a-little-wifi/mxm-immobilizer/(threads)

Thread 1 (2024-05-05):

Does it support both Nvidia and AMD cards?

iojeda, 2024-05-05:
Hi
First of all thank you very much for the amazing work you've done and thanks for sharing this great proyect as open source.
I have an old AMD MXM card rescued from a non working iMac from 2009 I was wondering what is the current status of your design and if I could use it safely there.

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

**Have you tested it?**

**Will it support any MXM card?**

In the board desing you say Watch out for propietary MXM pinout stuff might blow up :smile: so I wanted to ask before building it.

**Can you please help me to figure it out if  your design is a good fit for my card?**

**Or maybe just point me in the right direction on where to look for information to figure that out?**

**Will I need specific Driver or manufacturer driver will just work fine?**

Thanks
Regards, Ismael.

a-little-wifi, 2024-05-10:
Hi, sorry to keep you waiting, missed the notification about this.
The current state of the design is 'technically everything is connected, but it could be a lot better'. There's a list of changes I'd still like to make in the readme, but I don't have the time to work on it at the moment.
Regarding what cards it supports, in theory it should support anything that follows the MXM standard reasonably and has its own vbios chip. The proprietary pinout warning applies to cards that completely don't do that.
The card you've pictured, and any MXM card from an Apple device, should be a standard one, no danger of the pinout being different.

Personally, I would not recommend getting this board fabricated just yet, unless you're prepared to deal with whatever might not work as expected. It hasn't been manufactured and tested yet and is pretty much designed specifically to research a lot of the questions you're asking. I want to know the answers myself too, and this project is meant to help me find those answers.

The driver situation might be a funny one. This board itself doesn't need a driver of course, since it's mostly just a passive adapter, but especially with Nvidia MXM cards, the official driver is likely to refuse to install since it doesn't detect a known gpu-laptop combo. There are some ways around that, but that's not something I have tried a lot yet. On the other side of things, AMD doesn't have this kind of limitation as far as I'm aware, pretty sure those drivers should work no problem.

If you want to know more about MXM's weirdness, I would recommend checking out some forum threads about common laptop models that had MXM slots, mostly older HP ZBooks and Dell Precisions, but Apple iMacs too perhaps. There used to be whole communities around those things which included lots of people attempting to upgrade the MXM cards, with lots of useful info about what does and what doesn't work.
Unfortunately some of these older owners lounge threads are no longer easily available since the forum hosting them, forum.notebookreview.com, shut down, but they can still be read on web.archive.org and a dedicated archive website: nbrchive.net. They're lots of fun, would recommend checking them out, that's where I got a lot of my knowledge about MXM.

Hope this helps!

Thread 2 (2024-05-31):

Would like to test it!

Serbak, 2024-05-31:
Hey, I've seen the project and I've been really amazed by it, I would like to help!
I have many mxm cards to burn, so even if the pcb does not work properly and breaks some cards, It's not a big deal to me!

If you can help me print the pcb and make it ready, I'm up for testing!

Here is my discord if you want to talk about this more privately: Serback
:)

a-little-wifi, 2024-05-31:
Ohh hi, glad you like it!
That'd be awesome if you want to help test the design. Getting a fully assembled one will take some work, will need the pcb and parts ordered and assemble it. I'd be happy to help with the details on discord, that'll be a little more convenient. I'll reach out to you there.

Thread 3 (2025-04-01):

MXM Mini GPU

Paffo, 2025-04-01:
Hi,
sorry for creating an issue but i couldn't find your discord here on GH.
I was always interested in making the smallest GPU possible while still being able to more or less DIY it instead of buying it.

My current one is a GTX1060+Oculink and a small Server PSU, the full thing it's as big as a lunchbox, so not very 😅

When i found out that there are resellers for old or refurbished laptop GPUs, in MXM i thought i struck gold, however the MXM to PCIe adapters are prohibitively expensive in places like Aliexpress.

When i found your project i got the idea of slimming it down to be as small as possible, my current idea being Oculink (x4) as for the PCIe and a 200W12V GAN for the power, with just 3 DP ports as output.

Assembling such board would be a piece of cake as i work in electronic repairs, however designing it is another pair of hands, hence my question, do you think this is possible? How much complexity would be added if instead of oculink, straight on an ASM2464 for USB-C?

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

If the incredible (😂😂) Paint mockup didn't give you a stroke, what do you think?

a-little-wifi, 2025-04-01:
Hmm so, one thing to note that I haven't addressed on the PCB in this repo yet, is that MXM cards don't have any of the DC-blocking capacitors on the PCIe lanes which are usually present for half of the pairs on a PCIe card, so they have to be included on the adapter PCB. Other than that I don't think a signal amplifier to redriver or whatever is necessary if the cable run is short enough yeah.
Assuming you don't have much experience routing high-speed differential signals (mostly PCIe and DP in this case), this series on hackaday is an excellent resource (check out the followup articles at the bottom too) https://hackaday.com/2023/03/14/pcie-for-hackers-the-diffpair-prelude/

To slim it down, for most things you don't intend to use you can just straight up remove them and everything related to them yeah, that'll be fine. There's a few parts that are important to the operation of the MXM card in general though, mostly the power and thermal control signals.

For documentation, it's really helped me to look at laptop schematics that include MXM slots for a known working reference implementation (the EliteBook 8540W one is particularly nice for having a directly connected DP port).
You can also find the MXM specification online if you search for something like 'MXM 3.1 specification pdf' (probably slightly less than legal for me to just upload it directly, so you'll have to find it yourself)

Let me know if there's anything else you need, I'm happy to help!

Thread 4 (2025-08-12):

Status of this design

zbrozek, 2025-08-12:
I'd love to get some of these built and have a few questions:

- The readme says that the design isn't done yet; what's missing? How can I help?
- Has one of these been fabricated and tested yet? If so, did it work? If not, what's busted?
- Is this board designed with a cooler in mind? If so, which one?
- Is there a bracket design to go with this so that it can be mounted into a case?

Thanks!
