a-little-wifi/mxm-immobilizer/mxm immobilizer/mxm_immobilizer.kicad_sch

## KiCad design mxm immobilizer/mxm_immobilizer.kicad_sch (2026-01-29)

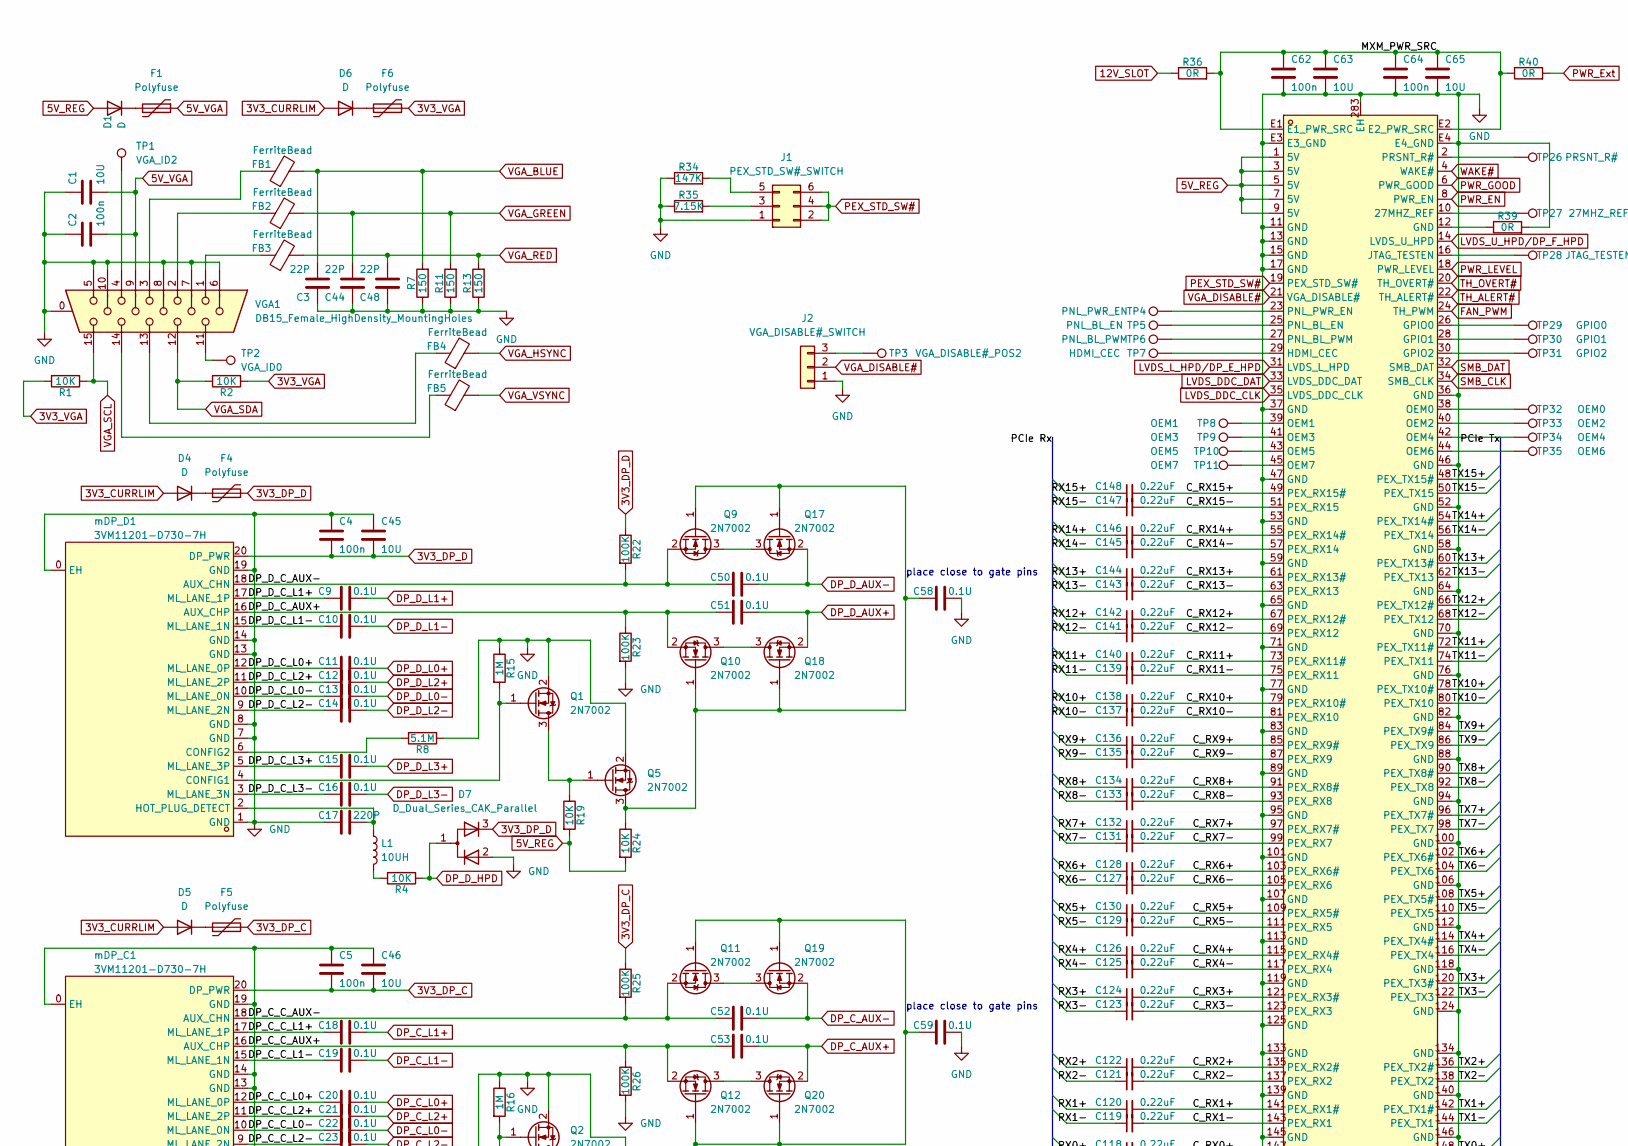
[picture p4: schematic mxm_immobilizer.kicad_sch, part in row 1, column 1]

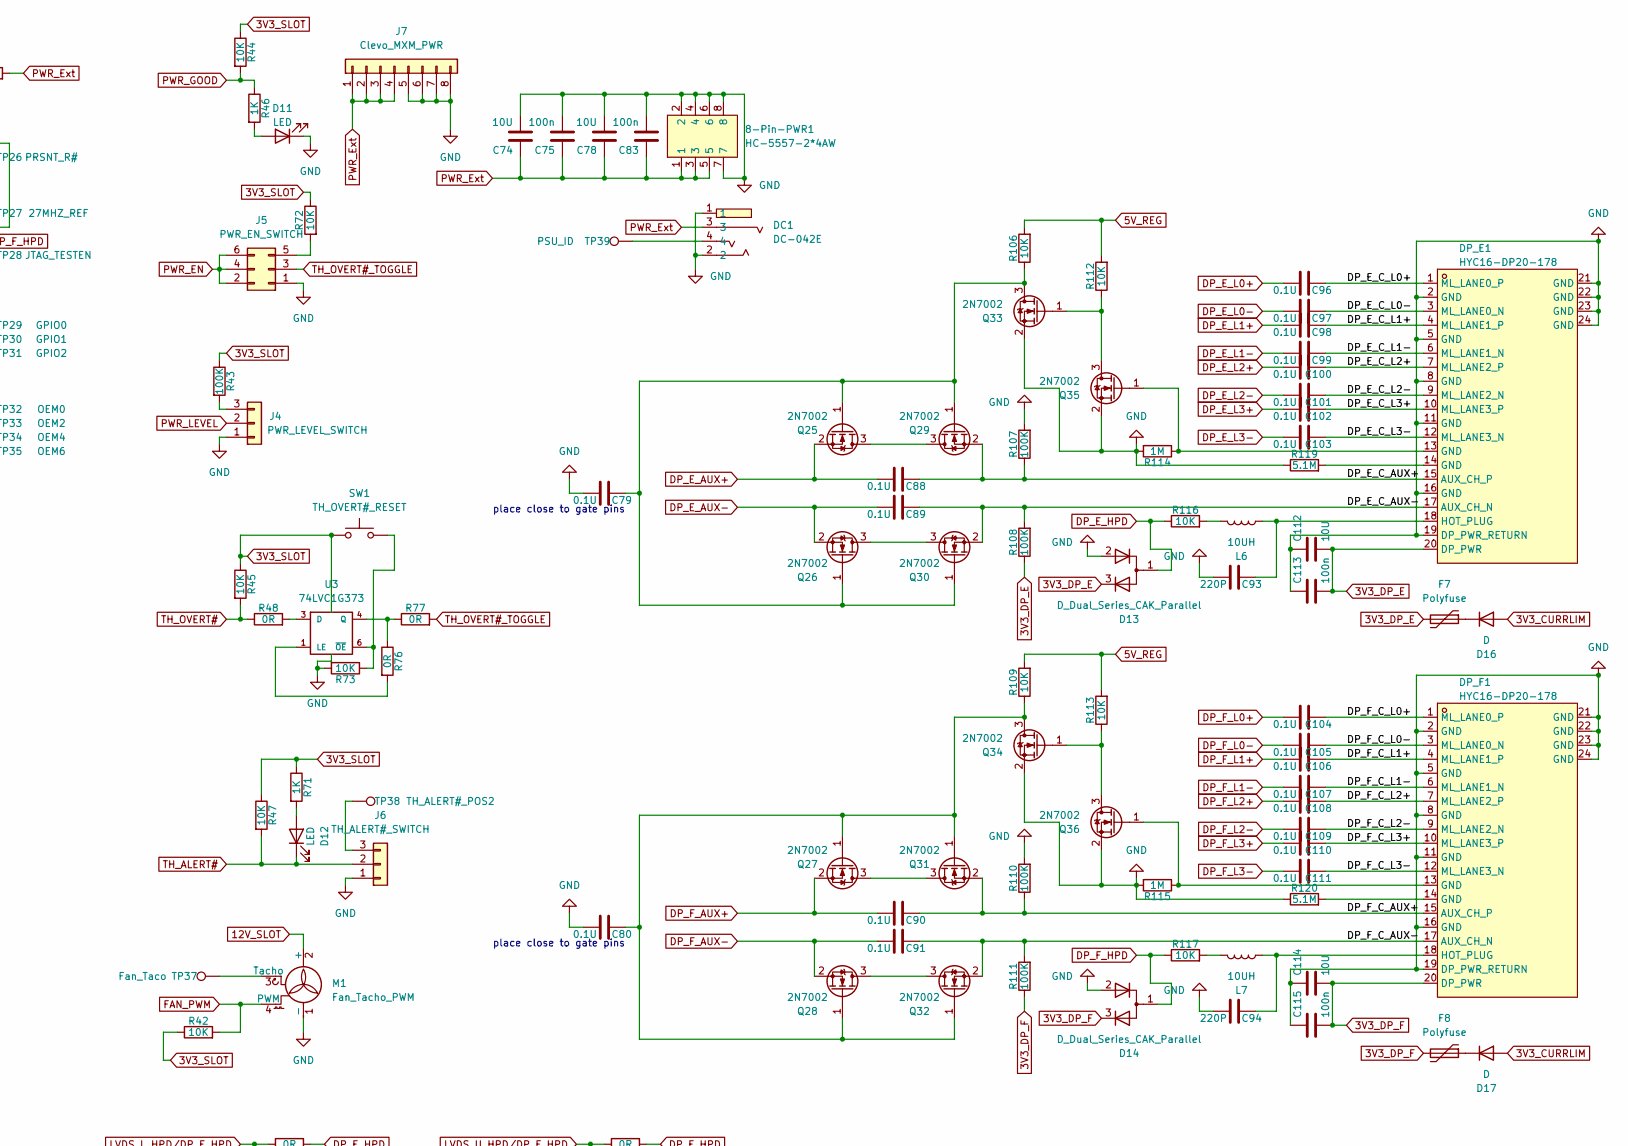
[picture p5: schematic mxm_immobilizer.kicad_sch, part in row 1, column 2]

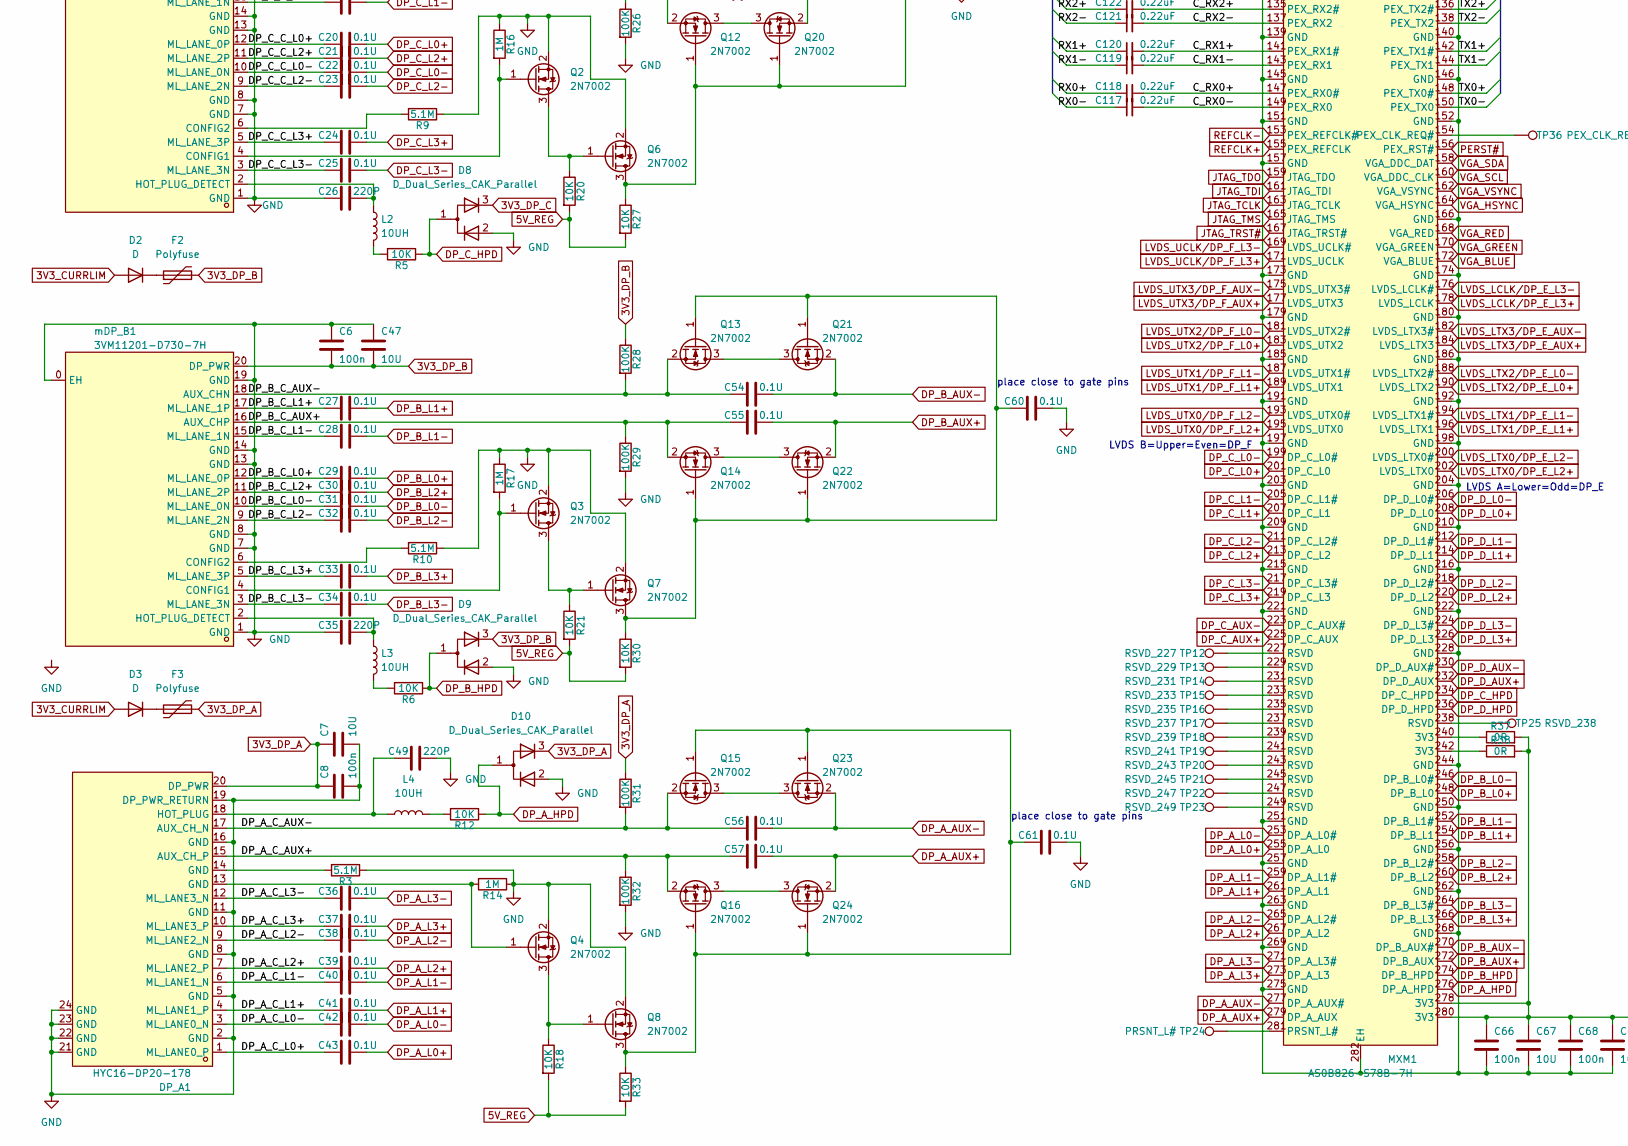
[picture p6: schematic mxm_immobilizer.kicad_sch, part in row 2, column 1]

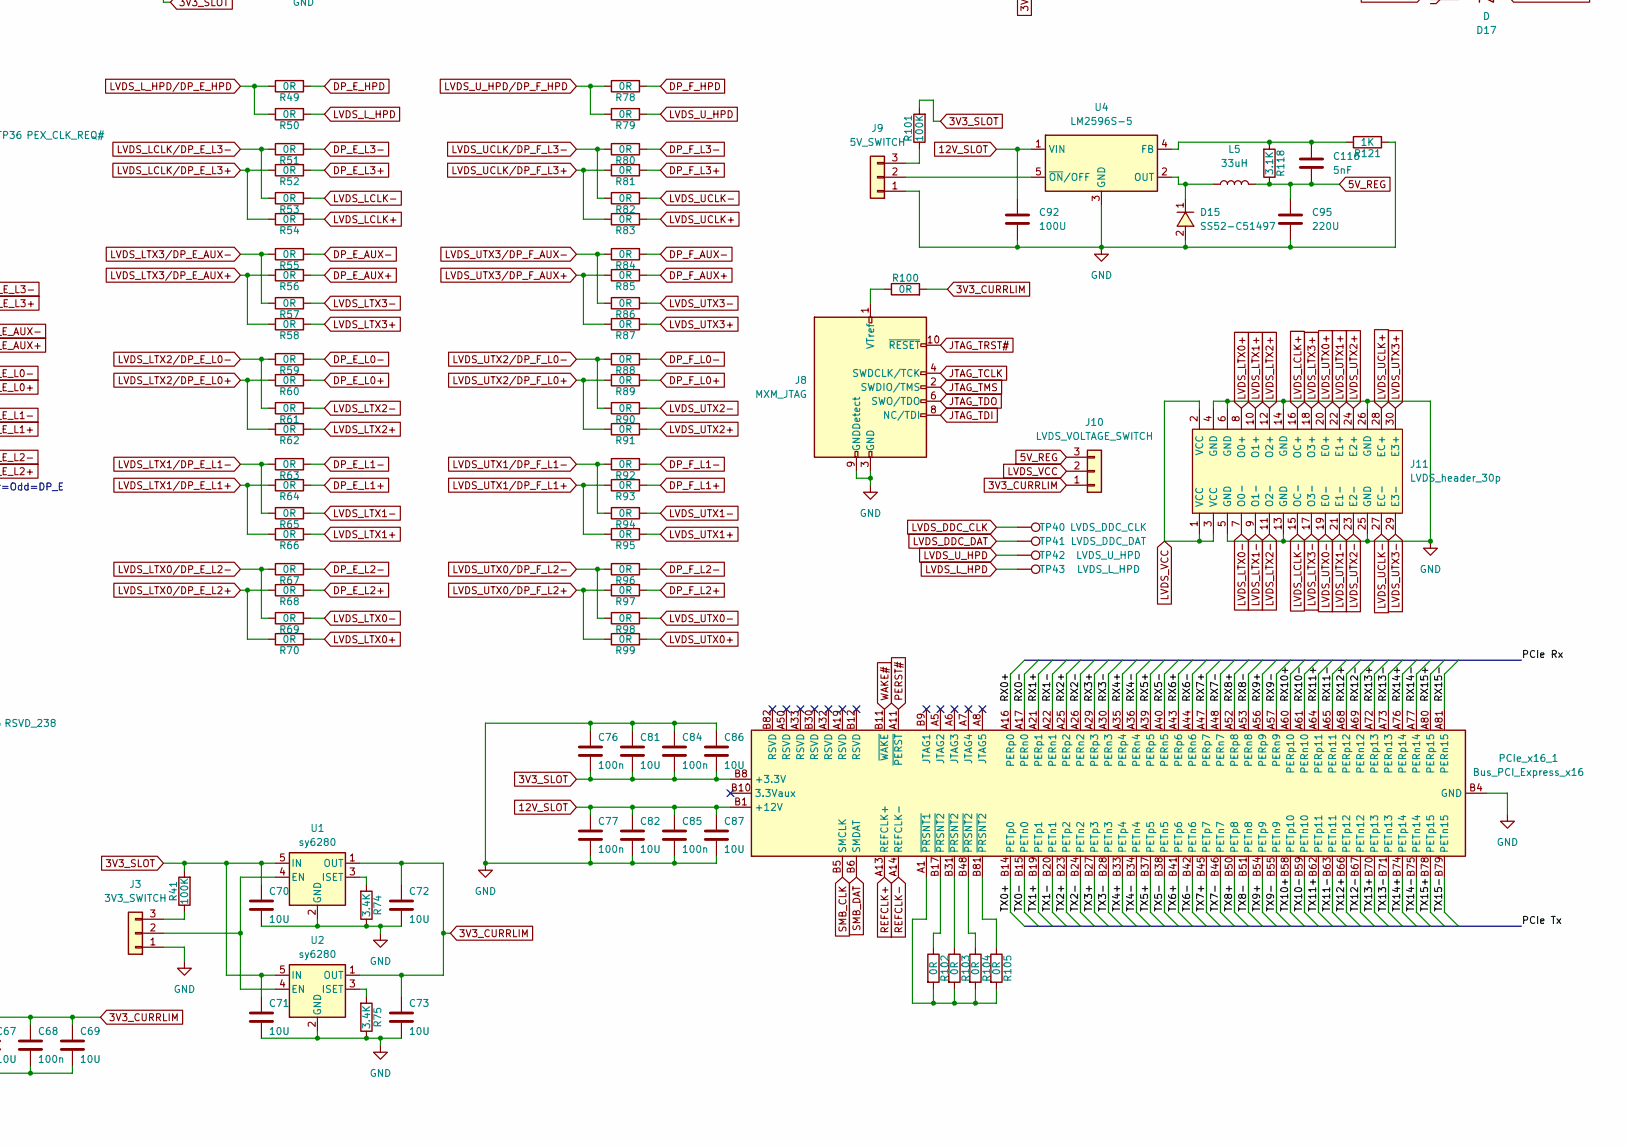
[picture p7: schematic mxm_immobilizer.kicad_sch, part in row 2, column 2]

Parts:
8-Pin-PWR1: HC-5557-2*4AW; CONN-TH_8P-P4.20_5557-2X4AW; LCSC Part C2845789
C1, C7, C45, C46, C47, C63, C65, C67, C69, C70, C71, C72, C73, C74, C78, C81, C82, C86, C87, C112, C114: 10U; C_0603_1608Metric_Pad1.08x0.95mm_HandSolder
C2, C4, C5, C6, C8, C62, C64, C66, C68, C75, C76, C77, C83, C84, C85, C113, C115: 100n; C_0603_1608Metric
C3, C44, C48: 22P; C_0603_1608Metric
C9, C10, C11, C12, C13, C14, C15, C16, C18, C19, C20, C21, C22, C23, C24, C25, C27, C28, C29, C30, C31, C32, C33, C34, C36, C37, C38, C39, C40, C41, C42, C43, C50, C51, C52, C53, C54, C55, C56, C57, C88, C89, C90, C91, C96, C97, C98, C99, C100, C101, C102, C103, C104, C105, C106, C107, C108, C109, C110, C111: 0.1U; C_0402_1005Metric
C17, C26, C35, C49, C93, C94: 220P; C_0603_1608Metric
C58, C59, C60, C61, C79, C80: 0.1U; C_0603_1608Metric
C92: 100U; C_Elec_6.3x7.7
C95: 220U; C_Elec_6.3x7.7
C116: 5nF; C_0603_1608Metric
C117, C118, C119, C120, C121, C122, C123, C124, C125, C126, C127, C128, C129, C130, C131, C132, C133, C134, C135, C136, C137, C138, C139, C140, C141, C142, C143, C144, C145, C146, C147, C148: 0.22uF; C_0402_1005Metric
D1, D2, D3, D4, D5, D6, D16, D17: D; D_SMA
D7, D8, D9, D10, D13, D14: D_Dual_Series_CAK_Parallel; SOT-23
D11, D12: LED; LED_0603_1608Metric
D15: SS52-C51497; SMB_L4.6-W3.6-LS5.3-RD; LCSC Part C51497
DC1: DC-042E; DC-IN-TH_DC-042E; LCSC Part C397340
DP_A1: HYC16-DP20-178; DP-SMD_HYC16-DP20-178; LCSC Part C711350
DP_E1: HYC16-DP20-178; DP-SMD_HYC16-DP20-178; LCSC Part C711350
DP_F1: HYC16-DP20-178; DP-SMD_HYC16-DP20-178; LCSC Part C711350
F1, F2, F3, F4, F5, F6, F7, F8: Polyfuse; Fuse_0805_2012Metric
FB1, FB2, FB3, FB4, FB5: FerriteBead; R_0402_1005Metric
J1: PEX_STD_SW#_SWITCH; PinHeader_2x03_P2.54mm_Vertical
J2: VGA_DISABLE#_SWITCH; PinHeader_1x03_P2.54mm_Vertical
J3: 3V3_SWITCH; PinHeader_1x03_P2.54mm_Vertical
J4: PWR_LEVEL_SWITCH; PinHeader_1x03_P2.54mm_Vertical
J5: PWR_EN_SWITCH; PinHeader_2x03_P2.54mm_Vertical
J6: TH_ALERT#_SWITCH; PinHeader_1x03_P2.54mm_Vertical
J7: Clevo_MXM_PWR; PinHeader_1x08_P2.00mm_Vertical_SMD_Pin1Left
J8: MXM_JTAG; PinHeader_2x05_P1.27mm_Vertical
J9: 5V_SWITCH; PinHeader_1x03_P2.54mm_Vertical
J10: LVDS_VOLTAGE_SWITCH; PinHeader_1x03_P2.54mm_Vertical
J11: LVDS_header_30p; PinHeader_2x15_P2.00mm_Vertical
L1, L2, L3, L4, L6, L7: 10UH; L_0603_1608Metric_Pad1.05x0.95mm_HandSolder
L5: 33uH; L_12x12mm_H8mm
M1: Fan_Tacho_PWM; FanPinHeader_1x04_P2.54mm_Vertical
MXM1: AS0B826-S78B-7H; CONN-SMD_AS0B826-S78B-7H; LCSC Part C426232
PCIe_x16_1: Bus_PCI_Express_x16; BUS_PCIexpress_x16
Q1, Q2, Q3, Q4, Q5, Q6, Q7, Q8, Q9, Q10, Q11, Q12, Q13, Q14, Q15, Q16, Q17, Q18, Q19, Q20, Q21, Q22, Q23, Q24, Q25, Q26, Q27, Q28, Q29, Q30, Q31, Q32, Q33, Q34, Q35, Q36: 2N7002; SOT-23
R1, R2, R4, R5, R6, R12, R18, R19, R20, R21, R24, R27, R30, R33, R42, R44, R45, R47, R72, R73, R106, R109, R112, R113, R116, R117: 10K; R_0603_1608Metric
R3, R8, R9, R10, R119, R120: 5.1M; R_0603_1608Metric
R7, R11, R13: 150; R_0603_1608Metric
R14, R15, R16, R17, R114, R115: 1M; R_0603_1608Metric
R22, R23, R25, R26, R28, R29, R31, R32, R41, R43, R101, R107, R108, R110, R111: 100K; R_0603_1608Metric
R34: 147K; R_0603_1608Metric
R35: 7.15K; R_0603_1608Metric
R36, R40: 0R; R_2816_7142Metric
R37, R38, R39, R48, R49, R50, R51, R52, R53, R54, R55, R56, R57, R58, R59, R60, R61, R62, R63, R64, R65, R66, R67, R68, R69, R70, R76, R77, R78, R79, R80, R81, R82, R83, R84, R85, R86, R87, R88, R89, R90, R91, R92, R93, R94, R95, R96, R97, R98, R99, R100, R102, R103, R104, R105: 0R; R_0603_1608Metric
R46, R71, R121: 1K; R_0603_1608Metric
R74, R75: 3.4K; R_0603_1608Metric
R118: 3.1K; R_0603_1608Metric
SW1: TH_OVERT#_RESET; SW_SPST_EVQPE1
TP1: VGA_ID2; PinHeader_1x01_P2.54mm_Vertical
TP2: VGA_ID0; PinHeader_1x01_P2.54mm_Vertical
TP3: VGA_DISABLE#_POS2; PinHeader_1x01_P2.54mm_Vertical
TP4: PNL_PWR_EN; PinHeader_1x01_P2.54mm_Vertical
TP5: PNL_BL_EN; PinHeader_1x01_P2.54mm_Vertical
TP6: PNL_BL_PWM; PinHeader_1x01_P2.54mm_Vertical
TP7: HDMI_CEC; PinHeader_1x01_P2.54mm_Vertical
TP8: OEM1; PinHeader_1x01_P2.54mm_Vertical
TP9: OEM3; PinHeader_1x01_P2.54mm_Vertical
TP10: OEM5; PinHeader_1x01_P2.54mm_Vertical
TP11: OEM7; PinHeader_1x01_P2.54mm_Vertical
TP12: RSVD_227; PinHeader_1x01_P2.54mm_Vertical
TP13: RSVD_229; PinHeader_1x01_P2.54mm_Vertical
TP14: RSVD_231; PinHeader_1x01_P2.54mm_Vertical
TP15: RSVD_233; PinHeader_1x01_P2.54mm_Vertical
TP16: RSVD_235; PinHeader_1x01_P2.54mm_Vertical
TP17: RSVD_237; PinHeader_1x01_P2.54mm_Vertical
TP18: RSVD_239; PinHeader_1x01_P2.54mm_Vertical
TP19: RSVD_241; PinHeader_1x01_P2.54mm_Vertical
TP20: RSVD_243; PinHeader_1x01_P2.54mm_Vertical
TP21: RSVD_245; PinHeader_1x01_P2.54mm_Vertical
TP22: RSVD_247; PinHeader_1x01_P2.54mm_Vertical
TP23: RSVD_249; PinHeader_1x01_P2.54mm_Vertical
TP24: PRSNT_L#; PinHeader_1x01_P2.54mm_Vertical
TP25: RSVD_238; PinHeader_1x01_P2.54mm_Vertical
TP26: PRSNT_R#; PinHeader_1x01_P2.54mm_Vertical
TP27: 27MHZ_REF; PinHeader_1x01_P2.54mm_Vertical
TP28: JTAG_TESTEN; PinHeader_1x01_P2.54mm_Vertical
TP29: GPIO0; PinHeader_1x01_P2.54mm_Vertical
TP30: GPIO1; PinHeader_1x01_P2.54mm_Vertical
TP31: GPIO2; PinHeader_1x01_P2.54mm_Vertical
TP32: OEM0; PinHeader_1x01_P2.54mm_Vertical
TP33: OEM2; PinHeader_1x01_P2.54mm_Vertical
TP34: OEM4; PinHeader_1x01_P2.54mm_Vertical
TP35: OEM6; PinHeader_1x01_P2.54mm_Vertical
TP36: PEX_CLK_REQ#; PinHeader_1x01_P2.54mm_Vertical
TP37: Fan_Taco; PinHeader_1x01_P2.54mm_Vertical
TP38: TH_ALERT#_POS2; PinHeader_1x01_P2.54mm_Vertical
TP39: PSU_ID; PinHeader_1x01_P2.54mm_Vertical
TP40: LVDS_DDC_CLK; PinHeader_1x01_P2.54mm_Vertical
TP41: LVDS_DDC_DAT; PinHeader_1x01_P2.54mm_Vertical
TP42: LVDS_U_HPD; PinHeader_1x01_P2.54mm_Vertical
TP43: LVDS_L_HPD; PinHeader_1x01_P2.54mm_Vertical
U1, U2: sy6280; SOT-23-5
U3: 74LVC1G373; SOT-23-6
U4: LM2596S-5; TO-263-5_TabPin3
VGA1: DB15_Female_HighDensity_MountingHoles; DSUB-TH_DS1038-15FBNSIA74-0CC
mDP_B1: 3VM11201-D730-7H; CONN-SMD_3VM11201-D730-7H; LCSC Part C2895506
mDP_C1: 3VM11201-D730-7H; CONN-SMD_3VM11201-D730-7H; LCSC Part C2895506
mDP_D1: 3VM11201-D730-7H; CONN-SMD_3VM11201-D730-7H; LCSC Part C2895506

Connections:
3V3_CURRLIM: C66.1, C67.1, C68.1, C69.1, C72.1, C73.1, D2.2 (A), D3.2 (A), D4.2 (A), D5.2 (A), D6.2 (A), D16.2 (A), D17.2 (A), J10.1, MXM1.278 (3V3), MXM1.280 (3V3), R37.2, R38.2, R100.2, U1.1 (OUT), U2.1 (OUT)
3V3_DP_A: C7.1, C8.1, D10.3 (K), DP_A1.20 (DP_PWR), F3.2, R31.1
3V3_DP_B: C6.2, C47.2, D9.3 (K), F2.2, R28.1, mDP_B1.20 (DP_PWR)
3V3_DP_C: C5.2, C46.2, D8.3 (K), F5.2, R25.1, mDP_C1.20 (DP_PWR)
3V3_DP_D: C4.2, C45.2, D7.3 (K), F4.2, R22.1, mDP_D1.20 (DP_PWR)
3V3_DP_E: C112.2, C113.2, D13.3 (K), DP_E1.20 (DP_PWR), F7.2, R108.1
3V3_DP_F: C114.2, C115.2, D14.3 (K), DP_F1.20 (DP_PWR), F8.2, R111.1
3V3_SLOT: C70.1, C71.1, C76.2, C81.2, C84.2, C86.2, PCIe_x16_1.A9 (+3.3V), PCIe_x16_1.A10 (+3.3V), PCIe_x16_1.B8 (+3.3V), R41.2, R42.1, R43.1, R44.1, R45.1, R47.1, R71.1, R72.1, R101.2, SW1.1, U1.5 (IN), U2.5 (IN), U3.5 (VCC)
3V3_VGA: F6.2, R1.2, R2.1
5V_REG: C95.1, C116.2, D1.2 (A), J10.3, L5.2, MXM1.1 (5V), MXM1.3 (5V), MXM1.5 (5V), MXM1.7 (5V), MXM1.9 (5V), R18.2, R19.2, R20.2, R21.2, R24.2, R27.2, R30.2, R33.2, R106.2, R109.2, R112.2, R113.2, R118.1
5V_VGA: C1.2, C2.2, F1.1, VGA1.9 (DDC_5V)
12V_SLOT: C77.1, C82.1, C85.1, C87.1, C92.1, M1.2 (+), PCIe_x16_1.A2 (+12V), PCIe_x16_1.A3 (+12V), PCIe_x16_1.B1 (+12V), PCIe_x16_1.B2 (+12V), PCIe_x16_1.B3 (+12V), R36.1, U4.1 (VIN)
C_RX0+: C118.2, MXM1.147 (PEX_RX0#)
C_RX0-: C117.2, MXM1.149 (PEX_RX0)
C_RX1+: C120.2, MXM1.141 (PEX_RX1#)
C_RX1-: C119.2, MXM1.143 (PEX_RX1)
C_RX2+: C122.2, MXM1.135 (PEX_RX2#)
C_RX2-: C121.2, MXM1.137 (PEX_RX2)
C_RX3+: C124.2, MXM1.121 (PEX_RX3#)
C_RX3-: C123.2, MXM1.123 (PEX_RX3)
C_RX4+: C126.2, MXM1.115 (PEX_RX4#)
C_RX4-: C125.2, MXM1.117 (PEX_RX4)
C_RX5+: C130.2, MXM1.109 (PEX_RX5#)
C_RX5-: C129.2, MXM1.111 (PEX_RX5)
C_RX6+: C128.2, MXM1.103 (PEX_RX6#)
C_RX6-: C127.2, MXM1.105 (PEX_RX6)
C_RX7+: C132.2, MXM1.97 (PEX_RX7#)
C_RX7-: C131.2, MXM1.99 (PEX_RX7)
C_RX8+: C134.2, MXM1.91 (PEX_RX8#)
C_RX8-: C133.2, MXM1.93 (PEX_RX8)
C_RX9+: C136.2, MXM1.85 (PEX_RX9#)
C_RX9-: C135.2, MXM1.87 (PEX_RX9)
C_RX10+: C138.2, MXM1.79 (PEX_RX10#)
C_RX10-: C137.2, MXM1.81 (PEX_RX10)
C_RX11+: C140.2, MXM1.73 (PEX_RX11#)
C_RX11-: C139.2, MXM1.75 (PEX_RX11)
C_RX12+: C142.2, MXM1.67 (PEX_RX12#)
C_RX12-: C141.2, MXM1.69 (PEX_RX12)
C_RX13+: C144.2, MXM1.61 (PEX_RX13#)
C_RX13-: C143.2, MXM1.63 (PEX_RX13)
C_RX14+: C146.2, MXM1.55 (PEX_RX14#)
C_RX14-: C145.2, MXM1.57 (PEX_RX14)
C_RX15+: C148.2, MXM1.49 (PEX_RX15#)
C_RX15-: C147.2, MXM1.51 (PEX_RX15)
DP_A_AUX+: C57.1, MXM1.279 (DP_A_AUX), Q24.2 (S)
DP_A_AUX-: C56.1, MXM1.277 (DP_A_AUX#), Q23.2 (S)
DP_A_C_AUX+: C57.2, DP_A1.15 (AUX_CH_P), Q16.2 (S), R32.1
DP_A_C_AUX-: C56.2, DP_A1.17 (AUX_CH_N), Q15.2 (S), R31.2
DP_A_C_L0+: C43.2, DP_A1.1 (ML_LANE0_P)
DP_A_C_L0-: C42.2, DP_A1.3 (ML_LANE0_N)
DP_A_C_L1+: C41.2, DP_A1.4 (ML_LANE1_P)
DP_A_C_L1-: C40.2, DP_A1.6 (ML_LANE1_N)
DP_A_C_L2+: C39.2, DP_A1.7 (ML_LANE2_P)
DP_A_C_L2-: C38.2, DP_A1.9 (ML_LANE2_N)
DP_A_C_L3+: C37.2, DP_A1.10 (ML_LANE3_P)
DP_A_C_L3-: C36.2, DP_A1.12 (ML_LANE3_N)
DP_A_HPD: D10.1 (A), MXM1.276 (DP_A_HPD), R12.1
DP_A_L0+: C43.1, MXM1.255 (DP_A_L0)
DP_A_L0-: C42.1, MXM1.253 (DP_A_L0#)
DP_A_L1+: C41.1, MXM1.261 (DP_A_L1)
DP_A_L1-: C40.1, MXM1.259 (DP_A_L1#)
DP_A_L2+: C39.1, MXM1.267 (DP_A_L2)
DP_A_L2-: C38.1, MXM1.265 (DP_A_L2#)
DP_A_L3+: C37.1, MXM1.273 (DP_A_L3)
DP_A_L3-: C36.1, MXM1.271 (DP_A_L3#)
DP_B_AUX+: C55.1, MXM1.272 (DP_B_AUX), Q22.2 (S)
DP_B_AUX-: C54.1, MXM1.270 (DP_B_AUX#), Q21.2 (S)
DP_B_C_AUX+: C55.2, Q14.2 (S), R29.1, mDP_B1.16 (AUX_CHP)
DP_B_C_AUX-: C54.2, Q13.2 (S), R28.2, mDP_B1.18 (AUX_CHN)
DP_B_C_L0+: C29.2, mDP_B1.12 (ML_LANE_0P)
DP_B_C_L0-: C31.2, mDP_B1.10 (ML_LANE_0N)
DP_B_C_L1+: C27.2, mDP_B1.17 (ML_LANE_1P)
DP_B_C_L1-: C28.2, mDP_B1.15 (ML_LANE_1N)
DP_B_C_L2+: C30.2, mDP_B1.11 (ML_LANE_2P)
DP_B_C_L2-: C32.2, mDP_B1.9 (ML_LANE_2N)
DP_B_C_L3+: C33.2, mDP_B1.5 (ML_LANE_3P)
DP_B_C_L3-: C34.2, mDP_B1.3 (ML_LANE_3N)
DP_B_HPD: D9.1 (A), MXM1.274 (DP_B_HPD), R6.1
DP_B_L0+: C29.1, MXM1.248 (DP_B_L0)
DP_B_L0-: C31.1, MXM1.246 (DP_B_L0#)
DP_B_L1+: C27.1, MXM1.254 (DP_B_L1)
DP_B_L1-: C28.1, MXM1.252 (DP_B_L1#)
DP_B_L2+: C30.1, MXM1.260 (DP_B_L2)
DP_B_L2-: C32.1, MXM1.258 (DP_B_L2#)
DP_B_L3+: C33.1, MXM1.266 (DP_B_L3)
DP_B_L3-: C34.1, MXM1.264 (DP_B_L3#)
DP_C_AUX+: C53.1, MXM1.225 (DP_C_AUX), Q20.2 (S)
DP_C_AUX-: C52.1, MXM1.223 (DP_C_AUX#), Q19.2 (S)
DP_C_C_AUX+: C53.2, Q12.2 (S), R26.1, mDP_C1.16 (AUX_CHP)
DP_C_C_AUX-: C52.2, Q11.2 (S), R25.2, mDP_C1.18 (AUX_CHN)
DP_C_C_L0+: C20.2, mDP_C1.12 (ML_LANE_0P)
DP_C_C_L0-: C22.2, mDP_C1.10 (ML_LANE_0N)
DP_C_C_L1+: C18.2, mDP_C1.17 (ML_LANE_1P)
DP_C_C_L1-: C19.2, mDP_C1.15 (ML_LANE_1N)
DP_C_C_L2+: C21.2, mDP_C1.11 (ML_LANE_2P)
DP_C_C_L2-: C23.2, mDP_C1.9 (ML_LANE_2N)
DP_C_C_L3+: C24.2, mDP_C1.5 (ML_LANE_3P)
DP_C_C_L3-: C25.2, mDP_C1.3 (ML_LANE_3N)
DP_C_HPD: D8.1 (A), MXM1.234 (DP_C_HPD), R5.1
DP_C_L0+: C20.1, MXM1.201 (DP_C_L0)
DP_C_L0-: C22.1, MXM1.199 (DP_C_L0#)
DP_C_L1+: C18.1, MXM1.207 (DP_C_L1)
DP_C_L1-: C19.1, MXM1.205 (DP_C_L1#)
DP_C_L2+: C21.1, MXM1.213 (DP_C_L2)
DP_C_L2-: C23.1, MXM1.211 (DP_C_L2#)
DP_C_L3+: C24.1, MXM1.219 (DP_C_L3)
DP_C_L3-: C25.1, MXM1.217 (DP_C_L3#)
DP_D_AUX+: C51.1, MXM1.232 (DP_D_AUX), Q18.2 (S)
DP_D_AUX-: C50.1, MXM1.230 (DP_D_AUX#), Q17.2 (S)
DP_D_C_AUX+: C51.2, Q10.2 (S), R23.1, mDP_D1.16 (AUX_CHP)
DP_D_C_AUX-: C50.2, Q9.2 (S), R22.2, mDP_D1.18 (AUX_CHN)
DP_D_C_L0+: C11.2, mDP_D1.12 (ML_LANE_0P)
DP_D_C_L0-: C13.2, mDP_D1.10 (ML_LANE_0N)
DP_D_C_L1+: C9.2, mDP_D1.17 (ML_LANE_1P)
DP_D_C_L1-: C10.2, mDP_D1.15 (ML_LANE_1N)
DP_D_C_L2+: C12.2, mDP_D1.11 (ML_LANE_2P)
DP_D_C_L2-: C14.2, mDP_D1.9 (ML_LANE_2N)
DP_D_C_L3+: C15.2, mDP_D1.5 (ML_LANE_3P)
DP_D_C_L3-: C16.2, mDP_D1.3 (ML_LANE_3N)
DP_D_HPD: D7.1 (A), MXM1.236 (DP_D_HPD), R4.1
DP_D_L0+: C11.1, MXM1.208 (DP_D_L0)
DP_D_L0-: C13.1, MXM1.206 (DP_D_L0#)
DP_D_L1+: C9.1, MXM1.214 (DP_D_L1)
DP_D_L1-: C10.1, MXM1.212 (DP_D_L1#)
DP_D_L2+: C12.1, MXM1.220 (DP_D_L2)
DP_D_L2-: C14.1, MXM1.218 (DP_D_L2#)
DP_D_L3+: C15.1, MXM1.226 (DP_D_L3)
DP_D_L3-: C16.1, MXM1.224 (DP_D_L3#)
DP_E_AUX+: C88.1, Q25.2 (S), R56.2
DP_E_AUX-: C89.1, Q26.2 (S), R55.2
DP_E_C_AUX+: C88.2, DP_E1.15 (AUX_CH_P), Q29.2 (S), R107.1
DP_E_C_AUX-: C89.2, DP_E1.17 (AUX_CH_N), Q30.2 (S), R108.2
DP_E_C_L0+: C96.2, DP_E1.1 (ML_LANE0_P)
DP_E_C_L0-: C97.2, DP_E1.3 (ML_LANE0_N)
DP_E_C_L1+: C98.2, DP_E1.4 (ML_LANE1_P)
DP_E_C_L1-: C99.2, DP_E1.6 (ML_LANE1_N)
DP_E_C_L2+: C100.2, DP_E1.7 (ML_LANE2_P)
DP_E_C_L2-: C101.2, DP_E1.9 (ML_LANE2_N)
DP_E_C_L3+: C102.2, DP_E1.10 (ML_LANE3_P)
DP_E_C_L3-: C103.2, DP_E1.12 (ML_LANE3_N)
DP_E_HPD: D13.1 (A), R49.2, R116.1
DP_E_L0+: C96.1, R60.2
DP_E_L0-: C97.1, R59.2
DP_E_L1+: C98.1, R64.2
DP_E_L1-: C99.1, R63.2
DP_E_L2+: C100.1, R68.2
DP_E_L2-: C101.1, R67.2
DP_E_L3+: C102.1, R52.2
DP_E_L3-: C103.1, R51.2
DP_F_AUX+: C90.1, Q27.2 (S), R85.2
DP_F_AUX-: C91.1, Q28.2 (S), R84.2
DP_F_C_AUX+: C90.2, DP_F1.15 (AUX_CH_P), Q31.2 (S), R110.1
DP_F_C_AUX-: C91.2, DP_F1.17 (AUX_CH_N), Q32.2 (S), R111.2
DP_F_C_L0+: C104.2, DP_F1.1 (ML_LANE0_P)
DP_F_C_L0-: C105.2, DP_F1.3 (ML_LANE0_N)
DP_F_C_L1+: C106.2, DP_F1.4 (ML_LANE1_P)
DP_F_C_L1-: C107.2, DP_F1.6 (ML_LANE1_N)
DP_F_C_L2+: C108.2, DP_F1.7 (ML_LANE2_P)
DP_F_C_L2-: C109.2, DP_F1.9 (ML_LANE2_N)
DP_F_C_L3+: C110.2, DP_F1.10 (ML_LANE3_P)
DP_F_C_L3-: C111.2, DP_F1.12 (ML_LANE3_N)
DP_F_HPD: D14.1 (A), R78.2, R117.1
DP_F_L0+: C104.1, R89.2
DP_F_L0-: C105.1, R88.2
DP_F_L1+: C106.1, R93.2
DP_F_L1-: C107.1, R92.2
DP_F_L2+: C108.1, R97.2
DP_F_L2-: C109.1, R96.2
DP_F_L3+: C110.1, R81.2
DP_F_L3-: C111.1, R80.2
FAN_PWM: M1.4 (PWM), MXM1.24 (TH_PWM), R42.2
GND: 8-Pin-PWR1.2, 8-Pin-PWR1.4, 8-Pin-PWR1.6, 8-Pin-PWR1.7, 8-Pin-PWR1.8, C1.1, C2.1, C3.1, C4.1, C5.1, C6.1, C7.2, C8.2, C17.2, C26.2, C35.2, C44.1, C45.1, C46.1, C47.1, C48.1, C49.1, C58.1, C59.1, C60.1, C61.1, C62.2, C63.2, C64.2, C65.2, C66.2, C67.2, C68.2, C69.2, C70.2, C71.2, C72.2, C73.2, C74.2, C75.2, C76.1, C77.2, C78.2, C79.1, C80.1, C81.1, C82.2, C83.2, C84.1, C85.2, C86.1, C87.2, C92.2, C93.1, C94.1, C95.2, C112.1, C113.1, C114.1, C115.1, D7.2 (K), D8.2 (K), D9.2 (K), D10.2 (K), D11.1 (K), D13.2 (K), D14.2 (K), D15.2 (A), DC1.1, DC1.2, DP_A1.2 (GND), DP_A1.5 (GND), DP_A1.8 (GND), DP_A1.11 (GND), DP_A1.16 (GND), DP_A1.19 (DP_PWR_RETURN), DP_A1.21 (GND), DP_A1.22 (GND), DP_A1.23 (GND), DP_A1.24 (GND), DP_E1.2 (GND), DP_E1.5 (GND), DP_E1.8 (GND), DP_E1.11 (GND), DP_E1.16 (GND), DP_E1.19 (DP_PWR_RETURN), DP_E1.21 (GND), DP_E1.22 (GND), DP_E1.23 (GND), DP_E1.24 (GND), DP_F1.2 (GND), DP_F1.5 (GND), DP_F1.8 (GND), DP_F1.11 (GND), DP_F1.16 (GND), DP_F1.19 (DP_PWR_RETURN), DP_F1.21 (GND), DP_F1.22 (GND), DP_F1.23 (GND), DP_F1.24 (GND), J1.1, J2.1, J3.1, J4.1, J5.1, J6.1, J7.5, J7.6, J7.7, J7.8, J8.3 (GND), J8.5 (GND), J8.9 (GNDDetect), J9.1, J11.4 (GND), J11.5 (GND), J11.6 (GND), J11.13 (GND), J11.14 (GND), J11.25 (GND), J11.26 (GND), M1.1 (-), MXM1.11 (GND), MXM1.13 (GND), MXM1.15 (GND), MXM1.17 (GND), MXM1.36 (GND), MXM1.37 (GND), MXM1.46 (GND), MXM1.47 (GND), MXM1.52 (GND), MXM1.53 (GND), MXM1.58 (GND), MXM1.59 (GND), MXM1.64 (GND), MXM1.65 (GND), MXM1.70 (GND), MXM1.71 (GND), MXM1.76 (GND), MXM1.77 (GND), MXM1.82 (GND), MXM1.83 (GND), MXM1.88 (GND), MXM1.89 (GND), MXM1.94 (GND), MXM1.95 (GND), MXM1.100 (GND), MXM1.101 (GND), MXM1.106 (GND), MXM1.107 (GND), MXM1.112 (GND), MXM1.113 (GND), MXM1.118 (GND), MXM1.119 (GND), MXM1.124 (GND), MXM1.125 (GND), MXM1.133 (GND), MXM1.134 (GND), MXM1.139 (GND), MXM1.140 (GND), MXM1.145 (GND), MXM1.146 (GND), MXM1.151 (GND), MXM1.152 (GND), MXM1.157 (GND), MXM1.166 (GND), MXM1.173 (GND), MXM1.174 (GND), MXM1.179 (GND), MXM1.180 (GND), MXM1.185 (GND), MXM1.186 (GND), MXM1.191 (GND), MXM1.192 (GND), MXM1.197 (GND), MXM1.198 (GND), MXM1.203 (GND), MXM1.204 (GND), MXM1.209 (GND), MXM1.210 (GND), MXM1.215 (GND), MXM1.216 (GND), MXM1.221 (GND), MXM1.222 (GND), MXM1.228 (GND), MXM1.244 (GND), MXM1.250 (GND), MXM1.251 (GND), MXM1.256 (GND), MXM1.257 (GND), MXM1.262 (GND), MXM1.263 (GND), MXM1.268 (GND), MXM1.269 (GND), MXM1.275 (GND), MXM1.282 (EH), MXM1.283 (EH), MXM1.E3 (E3_GND), MXM1.E4 (E4_GND), PCIe_x16_1.A4 (GND), PCIe_x16_1.A12 (GND), PCIe_x16_1.A15 (GND), PCIe_x16_1.A18 (GND), PCIe_x16_1.A20 (GND), PCIe_x16_1.A23 (GND), PCIe_x16_1.A24 (GND), PCIe_x16_1.A27 (GND), PCIe_x16_1.A28 (GND), PCIe_x16_1.A31 (GND), PCIe_x16_1.A34 (GND), PCIe_x16_1.A37 (GND), PCIe_x16_1.A38 (GND), PCIe_x16_1.A41 (GND), PCIe_x16_1.A42 (GND), PCIe_x16_1.A45 (GND), PCIe_x16_1.A46 (GND), PCIe_x16_1.A49 (GND), PCIe_x16_1.A51 (GND), PCIe_x16_1.A54 (GND), PCIe_x16_1.A55 (GND), PCIe_x16_1.A58 (GND), PCIe_x16_1.A59 (GND), PCIe_x16_1.A62 (GND), PCIe_x16_1.A63 (GND), PCIe_x16_1.A66 (GND), PCIe_x16_1.A67 (GND), PCIe_x16_1.A70 (GND), PCIe_x16_1.A71 (GND), PCIe_x16_1.A74 (GND), PCIe_x16_1.A75 (GND), PCIe_x16_1.A78 (GND), PCIe_x16_1.A79 (GND), PCIe_x16_1.A82 (GND), PCIe_x16_1.B4 (GND), PCIe_x16_1.B7 (GND), PCIe_x16_1.B13 (GND), PCIe_x16_1.B16 (GND), PCIe_x16_1.B18 (GND), PCIe_x16_1.B21 (GND), PCIe_x16_1.B22 (GND), PCIe_x16_1.B25 (GND), PCIe_x16_1.B26 (GND), PCIe_x16_1.B29 (GND), PCIe_x16_1.B32 (GND), PCIe_x16_1.B35 (GND), PCIe_x16_1.B36 (GND), PCIe_x16_1.B39 (GND), PCIe_x16_1.B40 (GND), PCIe_x16_1.B43 (GND), PCIe_x16_1.B44 (GND), PCIe_x16_1.B47 (GND), PCIe_x16_1.B49 (GND), PCIe_x16_1.B52 (GND), PCIe_x16_1.B53 (GND), PCIe_x16_1.B56 (GND), PCIe_x16_1.B57 (GND), PCIe_x16_1.B60 (GND), PCIe_x16_1.B61 (GND), PCIe_x16_1.B64 (GND), PCIe_x16_1.B65 (GND), PCIe_x16_1.B68 (GND), PCIe_x16_1.B69 (GND), PCIe_x16_1.B72 (GND), PCIe_x16_1.B73 (GND), PCIe_x16_1.B76 (GND), PCIe_x16_1.B77 (GND), PCIe_x16_1.B80 (GND), Q1.2 (S), Q2.2 (S), Q3.2 (S), Q4.2 (S), Q5.2 (S), Q6.2 (S), Q7.2 (S), Q8.2 (S), Q33.2 (S), Q34.2 (S), Q35.2 (S), Q36.2 (S), R3.1, R7.1, R8.1, R9.1, R10.1, R11.1, R13.1, R14.1, R15.1, R16.1, R17.1, R23.2, R26.2, R29.2, R32.2, R34.1, R35.1, R39.2, R73.2, R74.1, R75.1, R107.2, R110.2, R114.2, R115.2, R119.1, R120.1, R121.2, U1.2 (GND), U2.2 (GND), U3.2 (GND), U4.3 (GND), VGA1.0, VGA1.5 (GND), VGA1.6 (RED_SHIELD), VGA1.7 (GREEN_SHIELD), VGA1.8 (BLUE_SHIELD), VGA1.10 (SYNC_RETURN), mDP_B1.0 (EH), mDP_B1.1 (GND), mDP_B1.7 (GND), mDP_B1.8 (GND), mDP_B1.13 (GND), mDP_B1.14 (GND), mDP_B1.19 (GND), mDP_C1.0 (EH), mDP_C1.1 (GND), mDP_C1.7 (GND), mDP_C1.8 (GND), mDP_C1.13 (GND), mDP_C1.14 (GND), mDP_C1.19 (GND), mDP_D1.0 (EH), mDP_D1.1 (GND), mDP_D1.7 (GND), mDP_D1.8 (GND), mDP_D1.13 (GND), mDP_D1.14 (GND), mDP_D1.19 (GND)
JTAG_TCLK: J8.4 (SWDCLK/TCK), MXM1.163 (JTAG_TCLK)
JTAG_TDI: J8.8 (NC/TDI), MXM1.161 (JTAG_TDI)
JTAG_TDO: J8.6 (SWO/TDO), MXM1.159 (JTAG_TDO)
JTAG_TMS: J8.2 (SWDIO/TMS), MXM1.165 (JTAG_TMS)
JTAG_TRST#: J8.10 (~RESET), MXM1.167 (JTAG_TRST#)
LVDS_DDC_CLK: MXM1.35 (LVDS_DDC_CLK), TP40.1
LVDS_DDC_DAT: MXM1.33 (LVDS_DDC_DAT), TP41.1
LVDS_LCLK+: J11.16 (OC+), R54.2
LVDS_LCLK-: J11.15 (OC-), R53.2
LVDS_LCLK/DP_E_L3+: MXM1.178 (LVDS_LCLK), R52.1, R54.1
LVDS_LCLK/DP_E_L3-: MXM1.176 (LVDS_LCLK#), R51.1, R53.1
LVDS_LTX0+: J11.8 (O0+), R70.2
LVDS_LTX0-: J11.7 (O0-), R69.2
LVDS_LTX0/DP_E_L2+: MXM1.202 (LVDS_LTX0), R68.1, R70.1
LVDS_LTX0/DP_E_L2-: MXM1.200 (LVDS_LTX0#), R67.1, R69.1
LVDS_LTX1+: J11.10 (O1+), R66.2
LVDS_LTX1-: J11.9 (O1-), R65.2
LVDS_LTX1/DP_E_L1+: MXM1.196 (LVDS_LTX1), R64.1, R66.1
LVDS_LTX1/DP_E_L1-: MXM1.194 (LVDS_LTX1#), R63.1, R65.1
LVDS_LTX2+: J11.12 (O2+), R62.2
LVDS_LTX2-: J11.11 (O2-), R61.2
LVDS_LTX2/DP_E_L0+: MXM1.190 (LVDS_LTX2), R60.1, R62.1
LVDS_LTX2/DP_E_L0-: MXM1.188 (LVDS_LTX2#), R59.1, R61.1
LVDS_LTX3+: J11.18 (O3+), R58.2
LVDS_LTX3-: J11.17 (O3-), R57.2
LVDS_LTX3/DP_E_AUX+: MXM1.184 (LVDS_LTX3), R56.1, R58.1
LVDS_LTX3/DP_E_AUX-: MXM1.182 (LVDS_LTX3#), R55.1, R57.1
LVDS_L_HPD: R50.2, TP43.1
LVDS_L_HPD/DP_E_HPD: MXM1.31 (LVDS_L_HPD), R49.1, R50.1
LVDS_UCLK+: J11.28 (EC+), R83.2
LVDS_UCLK-: J11.27 (EC-), R82.2
LVDS_UCLK/DP_F_L3+: MXM1.171 (LVDS_UCLK), R81.1, R83.1
LVDS_UCLK/DP_F_L3-: MXM1.169 (LVDS_UCLK#), R80.1, R82.1
LVDS_UTX0+: J11.20 (E0+), R99.2
LVDS_UTX0-: J11.19 (E0-), R98.2
LVDS_UTX0/DP_F_L2+: MXM1.195 (LVDS_UTX0), R97.1, R99.1
LVDS_UTX0/DP_F_L2-: MXM1.193 (LVDS_UTX0#), R96.1, R98.1
LVDS_UTX1+: J11.22 (E1+), R95.2
LVDS_UTX1-: J11.21 (E1-), R94.2
LVDS_UTX1/DP_F_L1+: MXM1.189 (LVDS_UTX1), R93.1, R95.1
LVDS_UTX1/DP_F_L1-: MXM1.187 (LVDS_UTX1#), R92.1, R94.1
LVDS_UTX2+: J11.24 (E2+), R91.2
LVDS_UTX2-: J11.23 (E2-), R90.2
LVDS_UTX2/DP_F_L0+: MXM1.183 (LVDS_UTX2), R89.1, R91.1
LVDS_UTX2/DP_F_L0-: MXM1.181 (LVDS_UTX2#), R88.1, R90.1
LVDS_UTX3+: J11.30 (E3+), R87.2
LVDS_UTX3-: J11.29 (E3-), R86.2
LVDS_UTX3/DP_F_AUX+: MXM1.177 (LVDS_UTX3), R85.1, R87.1
LVDS_UTX3/DP_F_AUX-: MXM1.175 (LVDS_UTX3#), R84.1, R86.1
LVDS_U_HPD: R79.2, TP42.1
LVDS_U_HPD/DP_F_HPD: MXM1.14 (LVDS_U_HPD), R78.1, R79.1
LVDS_VCC: J10.2, J11.1 (VCC), J11.2 (VCC), J11.3 (VCC)
MXM_PWR_SRC: C62.1, C63.1, C64.1, C65.1, MXM1.E1 (E1_PWR_SRC), MXM1.E2 (E2_PWR_SRC), R36.2, R40.1
unnamed: C17.1, L1.1, mDP_D1.2 (HOT_PLUG_DETECT)
unnamed: C26.1, L2.1, mDP_C1.2 (HOT_PLUG_DETECT)
unnamed: C35.1, L3.1, mDP_B1.2 (HOT_PLUG_DETECT)
unnamed: C49.2, DP_A1.18 (HOT_PLUG), L4.1
unnamed: C58.2, Q5.3 (D), Q9.1 (G), Q10.1 (G), Q17.1 (G), Q18.1 (G), R24.1
unnamed: C59.2, Q6.3 (D), Q11.1 (G), Q12.1 (G), Q19.1 (G), Q20.1 (G), R27.1
unnamed: C60.2, Q7.3 (D), Q13.1 (G), Q14.1 (G), Q21.1 (G), Q22.1 (G), R30.1
unnamed: C61.2, Q8.3 (D), Q15.1 (G), Q16.1 (G), Q23.1 (G), Q24.1 (G), R33.1
unnamed: C79.2, Q25.1 (G), Q26.1 (G), Q29.1 (G), Q30.1 (G), Q33.3 (D), R106.1
unnamed: C80.2, Q27.1 (G), Q28.1 (G), Q31.1 (G), Q32.1 (G), Q34.3 (D), R109.1
unnamed: C93.2, DP_E1.18 (HOT_PLUG), L6.1
unnamed: C94.2, DP_F1.18 (HOT_PLUG), L7.1
unnamed: C116.1, R118.2, R121.1, U4.4 (FB)
unnamed: D1.1 (K), F1.2
unnamed: D2.1 (K), F2.1
unnamed: D3.1 (K), F3.1
unnamed: D4.1 (K), F4.1
unnamed: D5.1 (K), F5.1
unnamed: D6.1 (K), F6.1
unnamed: D11.2 (A), R46.2
unnamed: D12.2 (A), R71.2
unnamed: D15.1 (C), L5.1, U4.2 (OUT)
unnamed: D16.1 (K), F7.1
unnamed: D17.1 (K), F8.1
unnamed: DC1.4, TP39.1
unnamed: DP_A1.13 (GND), Q4.1 (G), R14.2
unnamed: DP_A1.14 (GND), R3.2
unnamed: DP_E1.13 (GND), Q35.1 (G), R114.1
unnamed: DP_E1.14 (GND), R119.2
unnamed: DP_F1.13 (GND), Q36.1 (G), R115.1
unnamed: DP_F1.14 (GND), R120.2
unnamed: FB1.1, VGA1.3 (BLUE)
unnamed: FB2.1, VGA1.2 (GREEN)
unnamed: FB3.1, VGA1.1 (RED)
unnamed: FB4.1, VGA1.13 (HSYNC)
unnamed: FB5.1, VGA1.14 (VSYNC)
unnamed: J1.3, R35.2
unnamed: J1.5, R34.2
unnamed: J2.3, TP3.1
unnamed: J3.2, U1.4 (EN), U2.4 (EN)
unnamed: J3.3, R41.1
unnamed: J4.3, R43.2
unnamed: J5.5, R72.2
unnamed: J6.3, TP38.1
unnamed: J8.1 (VTref), R100.1
unnamed: J9.2, U4.5 (~ON/OFF)
unnamed: J9.3, R101.1
unnamed: L1.2, R4.2
unnamed: L2.2, R5.2
unnamed: L3.2, R6.2
unnamed: L4.2, R12.2
unnamed: L6.2, R116.2
unnamed: L7.2, R117.2
unnamed: M1.3 (Tacho), TP37.1
unnamed: MXM1.2 (PRSNT_R#), TP26.1
unnamed: MXM1.10 (27MHZ_REF), TP27.1
unnamed: MXM1.12 (GND), R39.1
unnamed: MXM1.16 (JTAG_TESTEN), TP28.1
unnamed: MXM1.23 (PNL_PWR_EN), TP4.1
unnamed: MXM1.25 (PNL_BL_EN), TP5.1
unnamed: MXM1.26 (GPIO0), TP29.1
unnamed: MXM1.27 (PNL_BL_PWM), TP6.1
unnamed: MXM1.28 (GPIO1), TP30.1
unnamed: MXM1.29 (HDMI_CEC), TP7.1
unnamed: MXM1.30 (GPIO2), TP31.1
unnamed: MXM1.38 (OEM0), TP32.1
unnamed: MXM1.39 (OEM1), TP8.1
unnamed: MXM1.40 (OEM2), TP33.1
unnamed: MXM1.41 (OEM3), TP9.1
unnamed: MXM1.42 (OEM4), TP34.1
unnamed: MXM1.43 (OEM5), TP10.1
unnamed: MXM1.44 (OEM6), TP35.1
unnamed: MXM1.45 (OEM7), TP11.1
unnamed: MXM1.154 (PEX_CLK_REQ#), TP36.1
unnamed: MXM1.227 (RSVD), TP12.1
unnamed: MXM1.229 (RSVD), TP13.1
unnamed: MXM1.231 (RSVD), TP14.1
unnamed: MXM1.233 (RSVD), TP15.1
unnamed: MXM1.235 (RSVD), TP16.1
unnamed: MXM1.237 (RSVD), TP17.1
unnamed: MXM1.238 (RSVD), TP25.1
unnamed: MXM1.239 (RSVD), TP18.1
unnamed: MXM1.240 (3V3), R37.1
unnamed: MXM1.241 (RSVD), TP19.1
unnamed: MXM1.242 (3V3), R38.1
unnamed: MXM1.243 (RSVD), TP20.1
unnamed: MXM1.245 (RSVD), TP21.1
unnamed: MXM1.247 (RSVD), TP22.1
unnamed: MXM1.249 (RSVD), TP23.1
unnamed: MXM1.281 (PRSNT_L#), TP24.1
unnamed: PCIe_x16_1.A1 (~PRSNT1), R102.2, R103.2, R104.2, R105.2
unnamed: PCIe_x16_1.B17 (~PRSNT2), R102.1
unnamed: PCIe_x16_1.B31 (~PRSNT2), R103.1
unnamed: PCIe_x16_1.B48 (~PRSNT2), R104.1
unnamed: PCIe_x16_1.B81 (~PRSNT2), R105.1
unnamed: Q1.1 (G), R15.2, mDP_D1.4 (CONFIG1)
unnamed: Q1.3 (D), Q5.1 (G), R19.1
unnamed: Q2.1 (G), R16.2, mDP_C1.4 (CONFIG1)
unnamed: Q2.3 (D), Q6.1 (G), R20.1
unnamed: Q3.1 (G), R17.2, mDP_B1.4 (CONFIG1)
unnamed: Q3.3 (D), Q7.1 (G), R21.1
unnamed: Q4.3 (D), Q8.1 (G), R18.1
unnamed: Q10.3 (D), Q18.3 (D)
unnamed: Q11.3 (D), Q19.3 (D)
unnamed: Q12.3 (D), Q20.3 (D)
unnamed: Q13.3 (D), Q21.3 (D)
unnamed: Q14.3 (D), Q22.3 (D)
unnamed: Q15.3 (D), Q23.3 (D)
unnamed: Q16.3 (D), Q24.3 (D)
unnamed: Q9.3 (D), Q17.3 (D)
unnamed: Q25.3 (D), Q29.3 (D)
unnamed: Q26.3 (D), Q30.3 (D)
unnamed: Q27.3 (D), Q31.3 (D)
unnamed: Q28.3 (D), Q32.3 (D)
unnamed: Q33.1 (G), Q35.3 (D), R112.1
unnamed: Q34.1 (G), Q36.3 (D), R113.1
unnamed: R8.2, mDP_D1.6 (CONFIG2)
unnamed: R9.2, mDP_C1.6 (CONFIG2)
unnamed: R10.2, mDP_B1.6 (CONFIG2)
unnamed: R48.2, U3.3 (D)
unnamed: R73.1, SW1.2, U3.6 (~OE)
unnamed: R74.2, U1.3 (ISET)
unnamed: R75.2, U2.3 (ISET)
unnamed: R76.1, R77.1, U3.4 (Q)
unnamed: R76.2, U3.1 (LE)
unnamed: TP1.1, VGA1.4 (ID2)
unnamed: TP2.1, VGA1.11 (ID0)
PERST#: MXM1.156 (PEX_RST#), PCIe_x16_1.A11 (~PERST)
PEX_STD_SW#: J1.2, J1.4, J1.6, MXM1.19 (PEX_STD_SW#)
PWR_EN: J5.2, J5.4, J5.6, MXM1.8 (PWR_EN)
PWR_Ext: 8-Pin-PWR1.1, 8-Pin-PWR1.3, 8-Pin-PWR1.5, C74.1, C75.1, C78.1, C83.1, DC1.3, J7.1, J7.2, J7.3, J7.4, R40.2
PWR_GOOD: MXM1.6 (PWR_GOOD), R44.2, R46.1
PWR_LEVEL: J4.2, MXM1.18 (PWR_LEVEL)
REFCLK+: MXM1.155 (PEX_REFCLK), PCIe_x16_1.A13 (REFCLK+)
REFCLK-: MXM1.153 (PEX_REFCLK#), PCIe_x16_1.A14 (REFCLK-)
RX0+: C118.1, PCIe_x16_1.A16 (PERp0)
RX0-: C117.1, PCIe_x16_1.A17 (PERn0)
RX1+: C120.1, PCIe_x16_1.A21 (PERp1)
RX1-: C119.1, PCIe_x16_1.A22 (PERn1)
RX2+: C122.1, PCIe_x16_1.A25 (PERp2)
RX2-: C121.1, PCIe_x16_1.A26 (PERn2)
RX3+: C124.1, PCIe_x16_1.A29 (PERp3)
RX3-: C123.1, PCIe_x16_1.A30 (PERn3)
RX4+: C126.1, PCIe_x16_1.A35 (PERp4)
RX4-: C125.1, PCIe_x16_1.A36 (PERn4)
RX5+: C130.1, PCIe_x16_1.A39 (PERp5)
RX5-: C129.1, PCIe_x16_1.A40 (PERn5)
RX6+: C128.1, PCIe_x16_1.A43 (PERp6)
RX6-: C127.1, PCIe_x16_1.A44 (PERn6)
RX7+: C132.1, PCIe_x16_1.A47 (PERp7)
RX7-: C131.1, PCIe_x16_1.A48 (PERn7)
RX8+: C134.1, PCIe_x16_1.A52 (PERp8)
RX8-: C133.1, PCIe_x16_1.A53 (PERn8)
RX9+: C136.1, PCIe_x16_1.A56 (PERp9)
RX9-: C135.1, PCIe_x16_1.A57 (PERn9)
RX10+: C138.1, PCIe_x16_1.A60 (PERp10)
RX10-: C137.1, PCIe_x16_1.A61 (PERn10)
RX11+: C140.1, PCIe_x16_1.A64 (PERp11)
RX11-: C139.1, PCIe_x16_1.A65 (PERn11)
RX12+: C142.1, PCIe_x16_1.A68 (PERp12)
RX12-: C141.1, PCIe_x16_1.A69 (PERn12)
RX13+: C144.1, PCIe_x16_1.A72 (PERp13)
RX13-: C143.1, PCIe_x16_1.A73 (PERn13)
RX14+: C146.1, PCIe_x16_1.A76 (PERp14)
RX14-: C145.1, PCIe_x16_1.A77 (PERn14)
RX15+: C148.1, PCIe_x16_1.A80 (PERp15)
RX15-: C147.1, PCIe_x16_1.A81 (PERn15)
SMB_CLK: MXM1.34 (SMB_CLK), PCIe_x16_1.B5 (SMCLK)
SMB_DAT: MXM1.32 (SMB_DAT), PCIe_x16_1.B6 (SMDAT)
TH_ALERT#: D12.1 (K), J6.2, MXM1.22 (TH_ALERT#), R47.2
TH_OVERT#: MXM1.20 (TH_OVERT#), R45.2, R48.1
TH_OVERT#_TOGGLE: J5.3, R77.2
TX0+: MXM1.148 (PEX_TX0#), PCIe_x16_1.B14 (PETp0)
TX0-: MXM1.150 (PEX_TX0), PCIe_x16_1.B15 (PETn0)
TX1+: MXM1.142 (PEX_TX1#), PCIe_x16_1.B19 (PETp1)
TX1-: MXM1.144 (PEX_TX1), PCIe_x16_1.B20 (PETn1)
TX2+: MXM1.136 (PEX_TX2#), PCIe_x16_1.B23 (PETp2)
TX2-: MXM1.138 (PEX_TX2), PCIe_x16_1.B24 (PETn2)
TX3+: MXM1.120 (PEX_TX3#), PCIe_x16_1.B27 (PETp3)
TX3-: MXM1.122 (PEX_TX3), PCIe_x16_1.B28 (PETn3)
TX4+: MXM1.114 (PEX_TX4#), PCIe_x16_1.B33 (PETp4)
TX4-: MXM1.116 (PEX_TX4), PCIe_x16_1.B34 (PETn4)
TX5+: MXM1.108 (PEX_TX5#), PCIe_x16_1.B37 (PETp5)
TX5-: MXM1.110 (PEX_TX5), PCIe_x16_1.B38 (PETn5)
TX6+: MXM1.102 (PEX_TX6#), PCIe_x16_1.B41 (PETp6)
TX6-: MXM1.104 (PEX_TX6), PCIe_x16_1.B42 (PETn6)
TX7+: MXM1.96 (PEX_TX7#), PCIe_x16_1.B45 (PETp7)
TX7-: MXM1.98 (PEX_TX7), PCIe_x16_1.B46 (PETn7)
TX8+: MXM1.90 (PEX_TX8#), PCIe_x16_1.B50 (PETp8)
TX8-: MXM1.92 (PEX_TX8), PCIe_x16_1.B51 (PETn8)
TX9+: MXM1.84 (PEX_TX9#), PCIe_x16_1.B54 (PETp9)
TX9-: MXM1.86 (PEX_TX9), PCIe_x16_1.B55 (PETn9)
TX10+: MXM1.78 (PEX_TX10#), PCIe_x16_1.B58 (PETp10)
TX10-: MXM1.80 (PEX_TX10), PCIe_x16_1.B59 (PETn10)
TX11+: MXM1.72 (PEX_TX11#), PCIe_x16_1.B62 (PETp11)
TX11-: MXM1.74 (PEX_TX11), PCIe_x16_1.B63 (PETn11)
TX12+: MXM1.66 (PEX_TX12#), PCIe_x16_1.B66 (PETp12)
TX12-: MXM1.68 (PEX_TX12), PCIe_x16_1.B67 (PETn12)
TX13+: MXM1.60 (PEX_TX13#), PCIe_x16_1.B70 (PETp13)
TX13-: MXM1.62 (PEX_TX13), PCIe_x16_1.B71 (PETn13)
TX14+: MXM1.54 (PEX_TX14#), PCIe_x16_1.B74 (PETp14)
TX14-: MXM1.56 (PEX_TX14), PCIe_x16_1.B75 (PETn14)
TX15+: MXM1.48 (PEX_TX15#), PCIe_x16_1.B78 (PETp15)
TX15-: MXM1.50 (PEX_TX15), PCIe_x16_1.B79 (PETn15)
VGA_BLUE: C3.2, FB1.2, MXM1.172 (VGA_BLUE), R7.2
VGA_DISABLE#: J2.2, MXM1.21 (VGA_DISABLE#)
VGA_GREEN: C44.2, FB2.2, MXM1.170 (VGA_GREEN), R11.2
VGA_HSYNC: FB4.2, MXM1.164 (VGA_HSYNC)
VGA_RED: C48.2, FB3.2, MXM1.168 (VGA_RED), R13.2
VGA_SCL: MXM1.160 (VGA_DDC_CLK), R1.1, VGA1.15 (ID3/CLK)
VGA_SDA: MXM1.158 (VGA_DDC_DAT), R2.2, VGA1.12 (ID1)
VGA_VSYNC: FB5.2, MXM1.162 (VGA_VSYNC)
WAKE#: MXM1.4 (WAKE#), PCIe_x16_1.B11 (~WAKE)

Notes on the sheet:
place close to gate pins
LVDS B=Upper=Even=DP_F
LVDS A=Lower=Odd=DP_E
