a-little-wifi/mxm-immobilizer/(commit log)

2024-02-11 Start of repo
    Added the files lol
    [mxm_immobilizer.kicad_sch]
2024-02-11 Changed folder structure + added readme
    It's probably better this way, also the readme has basically nothing in it lol
    [mxm_immobilizer.kicad_sch]
2024-12-17 Added todo about pcie caps and updated pcb file to kicad 8
2026-01-29 Added PCIe Rx capacitors (and updated to KiCad 9)
    should've done this ages ago...
    [mxm_immobilizer.kicad_sch]
2026-09-14 removed rx caps from todo
    idk why i didn't do that earlier, i put them on the pcb a long time ago
